jasonacox/Ender3-Filament-Digital-Scale/kicad/attiny85-digital-scale.sch

## KiCad design kicad/attiny85-digital-scale.sch (2020-06-24)

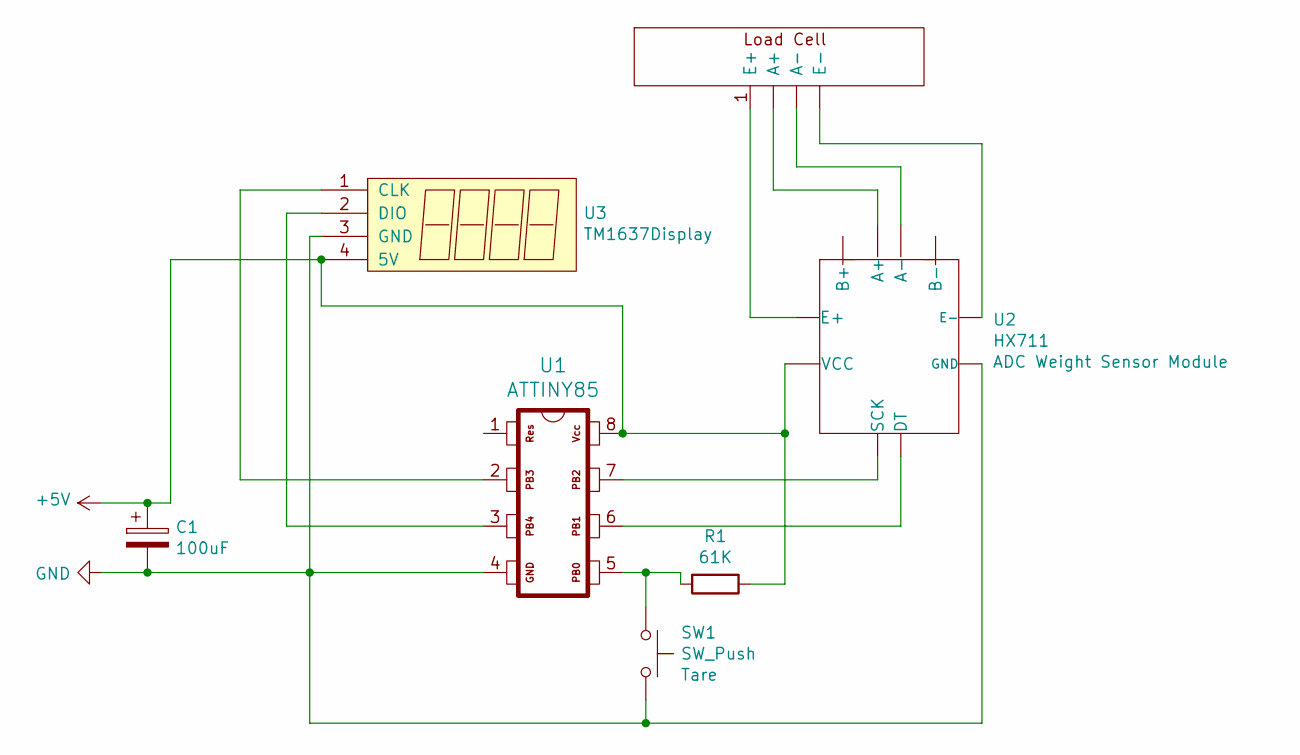
[picture p2: schematic attiny85-digital-scale.sch]

Parts:
C1: 100uF
R1: 61K
SW1: SW_Push
U1: ATTINY85
U2: HX711; ADC Weight Sensor Module
U3: TM1637Display

Connections:
+5V: C1.1, R1.1, U1.8, U2.~, U3.4 (5V)
GND: C1.2, SW1.2, U1.4, U2.~, U3.3 (GND)
unnamed: R1.2, SW1.1, U1.5
unnamed: U1.2, U3.1 (CLK)
unnamed: U1.3, U3.2 (DIO)
unnamed: U1.6, U2.~
unnamed: U1.7, U2.~
