jasonacox/Ender3-Filament-Digital-Scale/src/attiny85-hx711-tm1637-weight-display/segment.h

/* Set up 7-segment LED Binary Data

    |--A--|
    F     B
    |--G--|
    E     C
    |--D--|
           H - Decimal

    XGFEDCBA
  0b00000000 = 0x00
*/

/* Animation Data - HGFEDCBA Map */
const uint8_t ANIMATION[46][4] = {
  { 0x08, 0x00, 0x00, 0x00 },  // Frame 0
  { 0x00, 0x08, 0x00, 0x00 },  // Frame 1
  { 0x00, 0x00, 0x08, 0x00 },  // Frame 2
  { 0x00, 0x00, 0x00, 0x08 },  // Frame 3
  { 0x00, 0x00, 0x00, 0x04 },  // Frame 4
  { 0x00, 0x00, 0x00, 0x02 },  // Frame 5
  { 0x00, 0x00, 0x00, 0x01 },  // Frame 6
  { 0x00, 0x00, 0x01, 0x00 },  // Frame 7
  { 0x00, 0x01, 0x00, 0x00 },  // Frame 8
  { 0x01, 0x00, 0x00, 0x00 },  // Frame 9
  { 0x20, 0x00, 0x00, 0x00 },  // Frame 10
  { 0x10, 0x00, 0x00, 0x00 },  // Frame 11
  { 0x08, 0x00, 0x00, 0x00 },  // Frame 12
  { 0x00, 0x08, 0x00, 0x00 },  // Frame 13
  { 0x00, 0x00, 0x08, 0x00 },  // Frame 14
  { 0x00, 0x00, 0x00, 0x08 },  // Frame 15
  { 0x00, 0x00, 0x00, 0x04 },  // Frame 16
  { 0x00, 0x00, 0x00, 0x02 },  // Frame 17
  { 0x00, 0x00, 0x00, 0x01 },  // Frame 18
  { 0x00, 0x00, 0x01, 0x00 },  // Frame 19
  { 0x00, 0x01, 0x00, 0x00 },  // Frame 20
  { 0x01, 0x00, 0x00, 0x00 },  // Frame 21
  { 0x20, 0x00, 0x00, 0x00 },  // Frame 22
  { 0x10, 0x00, 0x00, 0x00 },  // Frame 23
  { 0x08, 0x00, 0x00, 0x00 },  // Frame 24
  { 0x18, 0x00, 0x00, 0x00 },  // Frame 25
  { 0x38, 0x00, 0x00, 0x00 },  // Frame 26
  { 0x39, 0x00, 0x00, 0x00 },  // Frame 27
  { 0x39, 0x01, 0x00, 0x00 },  // Frame 28
  { 0x39, 0x01, 0x01, 0x00 },  // Frame 29
  { 0x39, 0x01, 0x01, 0x01 },  // Frame 30
  { 0x39, 0x01, 0x01, 0x03 },  // Frame 31
  { 0x39, 0x01, 0x01, 0x07 },  // Frame 32
  { 0x39, 0x01, 0x01, 0x0f },  // Frame 33
  { 0x39, 0x01, 0x09, 0x0f },  // Frame 34
  { 0x39, 0x09, 0x09, 0x0f },  // Frame 35
  { 0x06, 0x09, 0x09, 0x30 },  // Frame 36
  { 0x00, 0x39, 0x0f, 0x00 },  // Frame 37
  { 0x00, 0x06, 0x30, 0x00 },  // Frame 38
  { 0x00, 0x46, 0x70, 0x00 },  // Frame 39
  { 0x40, 0x06, 0x30, 0x40 },  // Frame 40
  { 0x30, 0x06, 0x30, 0x06 },  // Frame 41
  { 0x30, 0x30, 0x06, 0x06 },  // Frame 42
  { 0x36, 0x00, 0x00, 0x36 },  // Frame 43
  { 0x30, 0x00, 0x00, 0x06 },  // Frame 44
  { 0x00, 0x00, 0x00, 0x00 }   // Frame 45
};
