jasonacox/Ender3-Filament-Digital-Scale/(commit log)

2020-06-24 Added schematic
2020-07-18 Updated calibration
2020-07-18 Updated Arduino version
2020-07-18 Updated setup calibration and animation
2020-07-18 Updated arduino path
2020-07-18 Linked Arduino dir
2020-07-18 arduino install libs
2020-07-18 Update arduino 1.8.12
2020-07-18 ATtiny85 pin notes
